a7akz/dc-motor-controller-stm32/photos/Stage 4 Evidence/PSU photo.jpeg

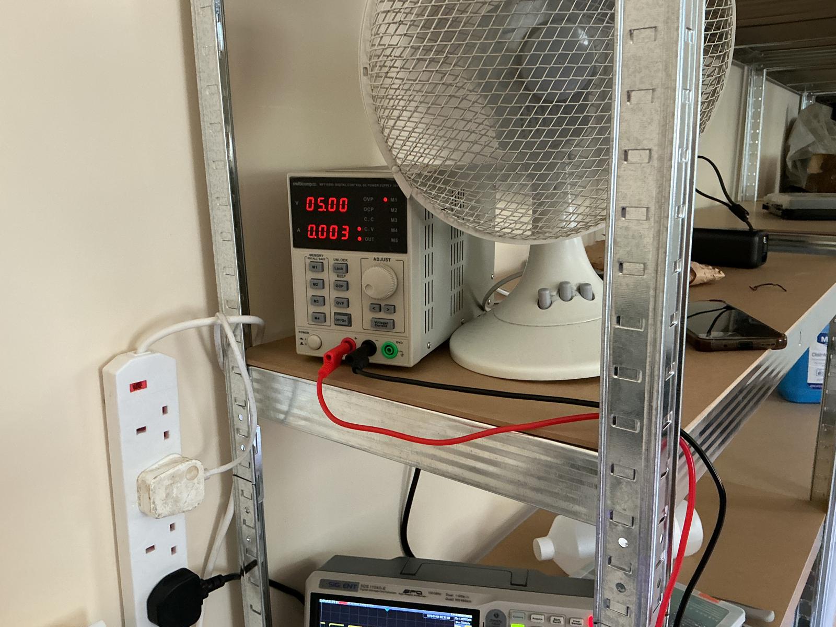
photos/Stage 4 Evidence/PSU photo.jpeg
