a7akz/dc-motor-controller-stm32/photos/Stage 4 Evidence/Stage 4 waveform.png

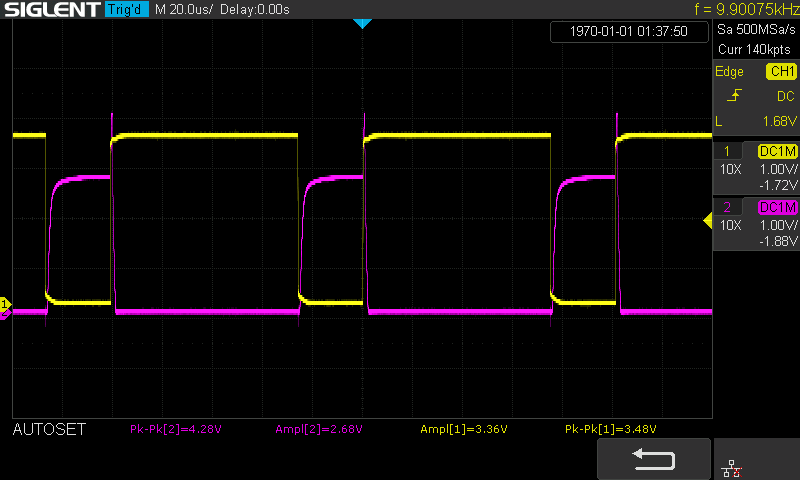
photos/Stage 4 Evidence/Stage 4 waveform.png
