a7akz/dc-motor-controller-stm32/photos/Stage 4 Evidence/Stage 4 Wiring.jpeg

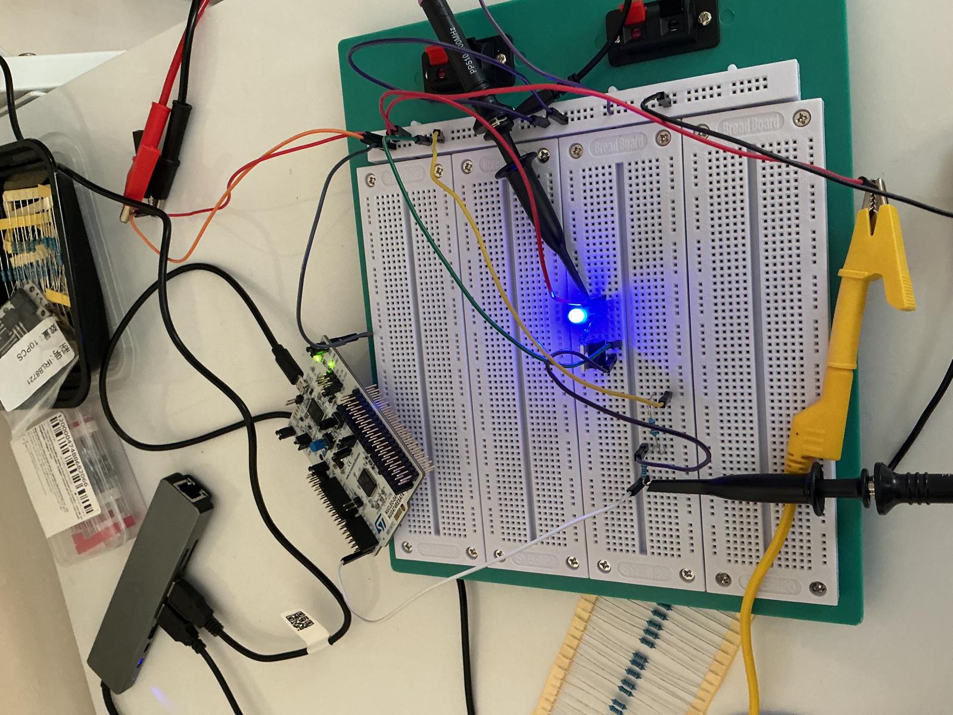
photos/Stage 4 Evidence/Stage 4 Wiring.jpeg
