a7akz/dc-motor-controller-stm32/STM32/DC Motor STM32/Core/Src/main.c

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
/* Includes ------------------------------------------------------------------*/
#include "main.h"

/* USER CODE BEGIN Includes */
#include <stdlib.h>
#include <stdio.h>

/* USER CODE END Includes */

TIM_HandleTypeDef htim1;
DMA_HandleTypeDef hdma_tim1_ch1;

UART_HandleTypeDef huart2;
DMA_HandleTypeDef hdma_usart2_rx;
DMA_HandleTypeDef hdma_usart2_tx;

void SystemClock_Config(void);
static void MX_GPIO_Init(void);
static void MX_DMA_Init(void);
static void MX_TIM1_Init(void);
static void MX_USART2_UART_Init(void);
/* USER CODE BEGIN 0 */

char rxBuf[4]; //Receives input
uint8_t ch; //Buffer to store into rxBuf
uint8_t i; //Index
char txBuf[20]; //Outputs duty cycle
int duty = 0; //Directly changes duty

/* USER CODE END 0 */

/**
  * @brief  The application entry point.
  * @retval int
  */
int main(void)
{

  /* MCU Configuration--------------------------------------------------------*/

  /* Reset of all peripherals, Initializes the Flash interface and the Systick. */
  HAL_Init();

  /* Configure the system clock */
  SystemClock_Config();

  /* Initialize all configured peripherals */
  MX_GPIO_Init();
  MX_DMA_Init();
  MX_TIM1_Init();
  MX_USART2_UART_Init();
  /* USER CODE BEGIN 2 */

  TIM1 -> CCR1 = duty; //CCR is made to equal to duty variable
  HAL_TIM_PWM_Start(&htim1, TIM_CHANNEL_1); //PWM by itself





  /* USER CODE END 2 */

  /* Infinite loop */
  /* USER CODE BEGIN WHILE */
  while (1)
  {
    /* USER CODE END WHILE */

    /* USER CODE BEGIN 3 */
	  HAL_UART_Receive(&huart2, &ch, 1, HAL_MAX_DELAY); //Receives each character
	  if(ch == '\r' ||ch == '\n' ) { //If enter moves to change duty
		  if (i > 0) { //Makes sure it runs when there is at least something in rxBuf
		  rxBuf[i] = '\0'; //Sets the index as \0 to indicate end off.

		  duty = atoi(rxBuf); //Converts rxBuf values to an actual integer

		  if(duty < 0) duty = 0; //Makes sure that program doesnt break by entering less than 0 or more than 100
		  if(duty > 100) duty = 100;

		  int len = snprintf(txBuf, sizeof(txBuf), "Duty Cycle: %d%%\r\n", duty); //snprint returns a length and also reformats txbuf to the string typed

		  HAL_UART_Transmit_DMA(&huart2,(uint8_t *) txBuf, len); //Outputs duty cycle value

		  TIM1 -> CCR1 = duty; //Changes duty cycle

		  i = 0; //Sets indx back to 0 to start again
		  }
	  }

	  else if((ch >= '0') && (ch <= '9')) { //If no enter and want to enter more values

		  if (i < sizeof(rxBuf) - 1) rxBuf[i++] = ch; // makes sure you cant enter more than 3 values and also makes rxBuf = ch
	  }

  }
  /* USER CODE END 3 */
}

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
