a7akz/dc-motor-controller-stm32/(commit log)

2026-05-30 LED project
2026-06-15 UART Int Variable into string
2026-06-16 UART Interrupt
2026-06-16 UART DMA Normal
2026-06-16 UART DMA Circular different V
2026-06-16 UART DMA Circular HALF/FULL Complete, final notes
2026-06-18 UARTRx Interrupt
2026-06-25 Stage 4: MOSFET LED AND RESISTOR test
2026-06-25 Complete Stage 5 open-loop motor PWM test
